vitktor/stereo-drone-tracking/stereo-rig-overview.png

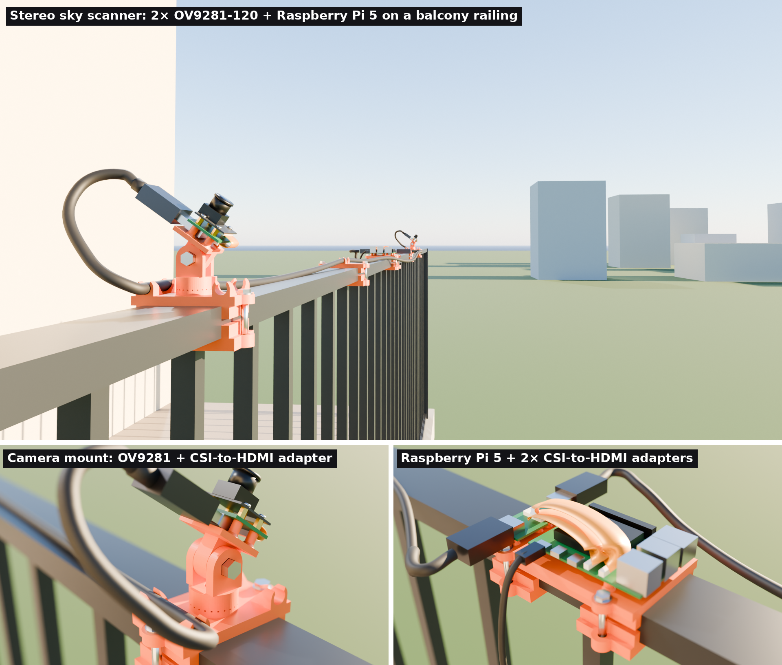
stereo-rig-overview.png
