vitktor/stereo-drone-tracking/3d-models/printing/remaining.3mf

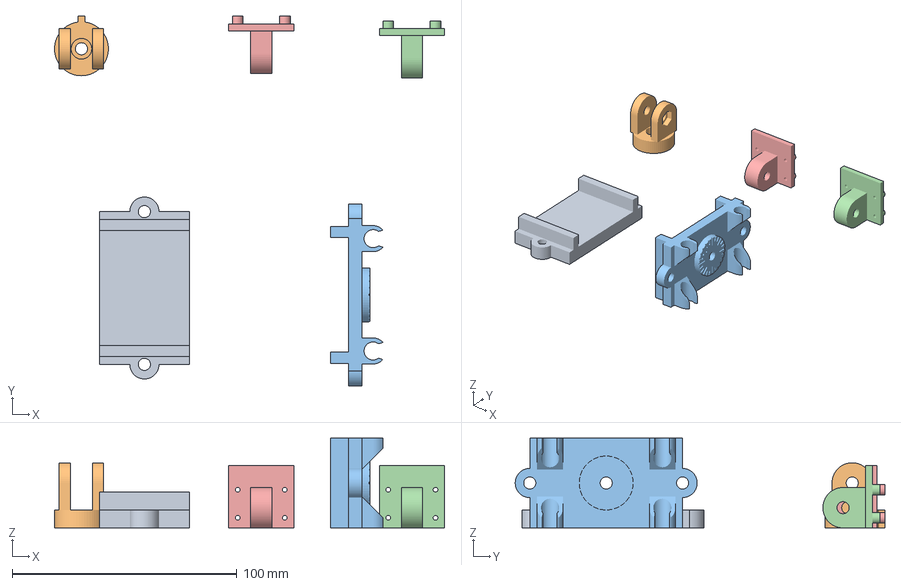
[picture p7: CAD file, 2026-10-20]
3d-models/printing/remaining.3mf
173.6 x 164.5 x 40.0 mm
jaw (5).stl
yoke (2).stl
saddle-clips
camera-holder x 2
