vitktor/stereo-drone-tracking/3d-models/parts/full-camera-holder.3mf

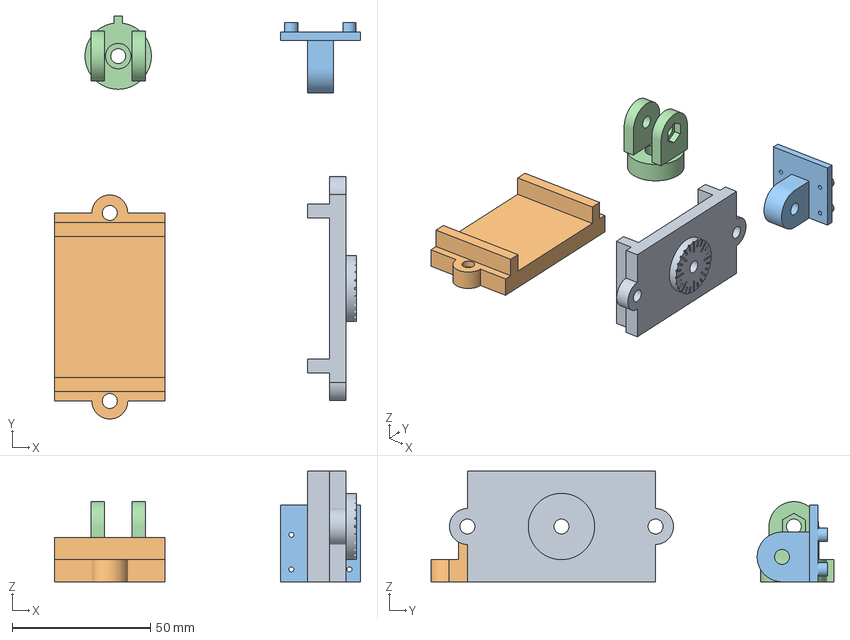
[picture p8: CAD file, 2026-10-20]
3d-models/parts/full-camera-holder.3mf
110.6 x 145.7 x 40.0 mm
saddle (6).stl
jaw (5).stl
camera (3).stl
yoke (2).stl
