vitktor/stereo-drone-tracking/3d-models/parts/saddle.3mf

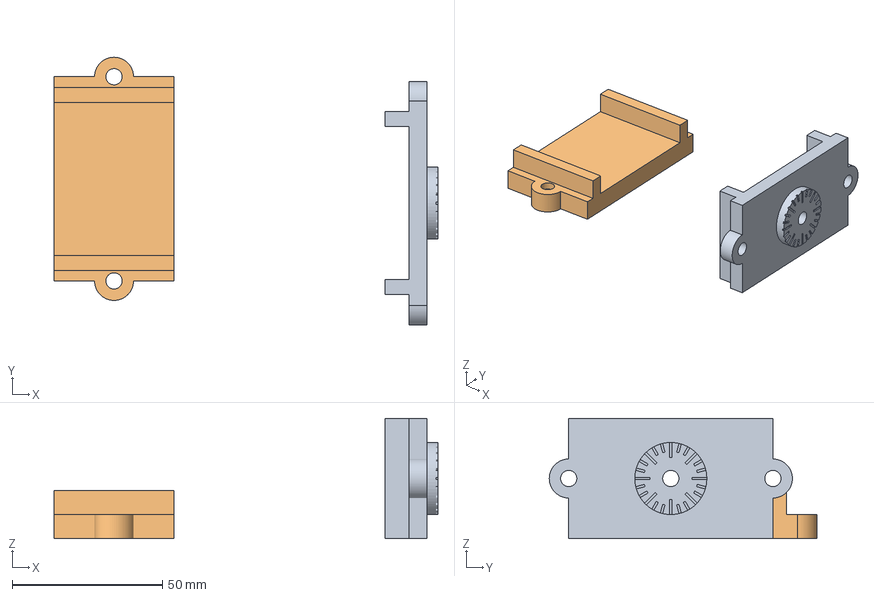
[picture p9: CAD file, 2026-10-20]
3d-models/parts/saddle.3mf
127.9 x 89.1 x 40.0 mm
saddle (6).stl
jaw (5).stl
