vitktor/stereo-drone-tracking/3d-models/parts/camera-rotator.3mf

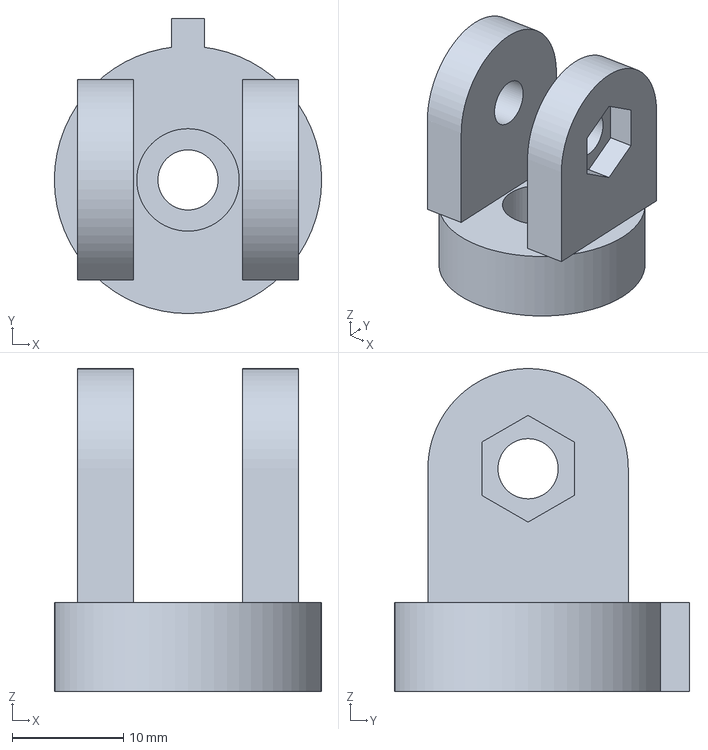
[picture p10: CAD file, 2026-10-20]
3d-models/parts/camera-rotator.3mf
24.0 x 26.5 x 29.0 mm
