vitktor/stereo-drone-tracking/3d-models/parts/hdmi-cable-holders.3mf

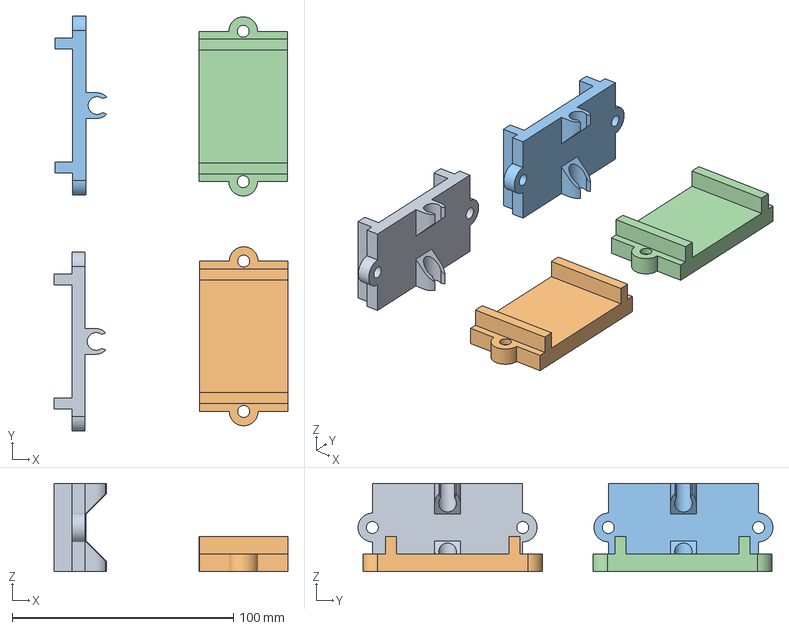
[picture p11: CAD file, 2026-10-20]
3d-models/parts/hdmi-cable-holders.3mf
105.8 x 187.7 x 40.0 mm
cable-holder-saddle x 2
jaw x 2
