vitktor/stereo-drone-tracking/3d-models/parts/saddle-for-RPi-5.3mf

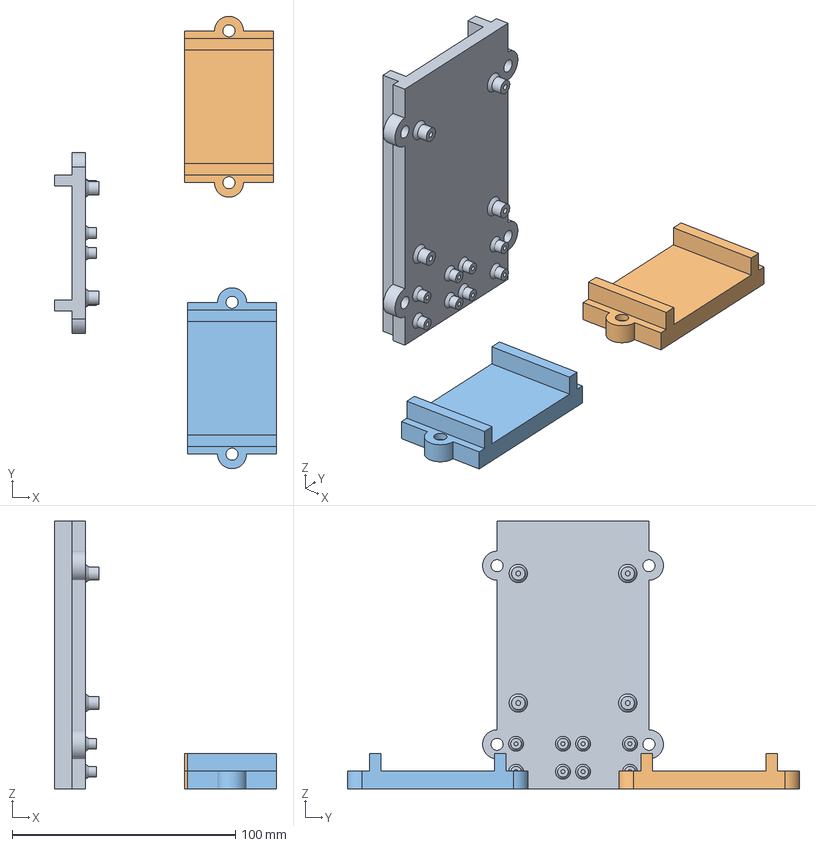
[picture p12: CAD file, 2026-10-20]
3d-models/parts/saddle-for-RPi-5.3mf
99.6 x 202.5 x 120.0 mm
pi5-saddle
jaw-2 x 2
