vitktor/stereo-drone-tracking/3d-models/parts/saddle-with-cable-clips.3mf

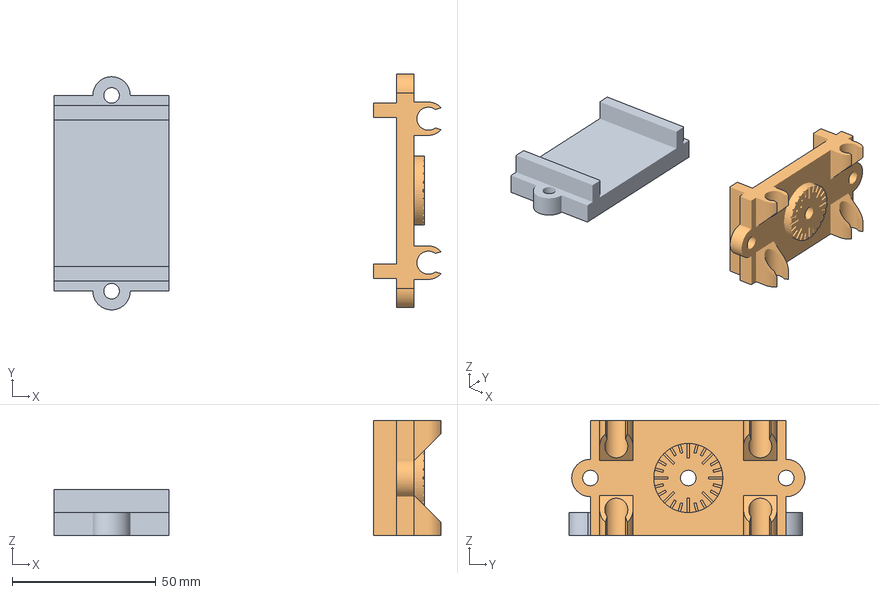
[picture p13: CAD file, 2026-10-20]
3d-models/parts/saddle-with-cable-clips.3mf
134.4 x 81.9 x 40.0 mm
jaw-2
saddle-clips
