vitktor/stereo-drone-tracking/3d-models/parts/camera-holder.3mf

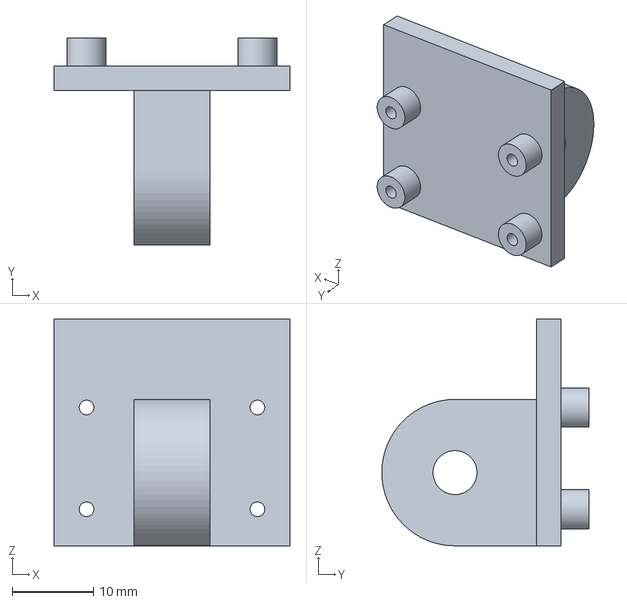
[picture p14: CAD file, 2026-10-20]
3d-models/parts/camera-holder.3mf
29.0 x 25.5 x 27.9 mm
