vitktor/stereo-drone-tracking/(list of files, cad)

Other CAD files:
3d-models/printing/saddle-for-RPi-5.3mf
