vitktor/stereo-drone-tracking/(commit log)

2026-10-20 Add camera calibration, stereo sync test and YOLO test
    - calibration/: single-camera intrinsic calibration for the two OV9281
    modules (labelled A and B): Pi streaming, capture, review and
    calibration scripts, plus the results calib_A.yaml and calib_B.yaml
    - test-sync/: hardware-synced stereo streaming from the Pi 5 and a
    Mac-side viewer
    - test-yolo/: capture a still over SSH and run YOLO11 on it
    - 3d-models/: camera holders and RPi 5 mount
    - requirements.txt and .gitignore for a single project venv
2026-10-21 Rewrite README with project intro, hardware photo and calibration sections
2026-10-21 Add intrinsics calibration section with checkerboard grid
2026-10-23 Use auto exposure on camera 0 and mirror it to camera 1 in sync stream
2026-10-23 Add drone dataset capture and stereo pair review scripts
    - detection/capture.py: live view of the one-camera or synced stereo
    stream, auto-saves frames or pairs per session with a start countdown;
    pairs share a number and are logged in pairs.csv
    - calibration/review_pairs.py: step through stereo pairs with board
    detection and copy the chosen ones to kept/
2026-10-23 Add stereo extrinsics calibration and its result
    calibrate_stereo.py calibrates R and T between cameras A and B from
    synced checkerboard pairs in images/ext with the intrinsics held fixed,
    checks the result by triangulating the board squares, and writes
    calib_stereo.yaml (79 pairs: 0.47 px RMS, 1965 mm baseline).
2026-10-23 Add extrinsics calibration sections with checkerboard and drone LED images
2026-10-26 Add live drone tracking on the Pi and compare NCNN and ONNX detector speed
    live/track.py runs synced capture, YOLO in both views, triangulation and a forward Kalman filter (live/filter.py) on the Pi; live/view.py shows the result on the Mac.
    The point matching and the room frame move into reconstruction/stereo.py, shared by the live and offline code.
